KunYi/nRFMicro/3D Models/USP-6C.step

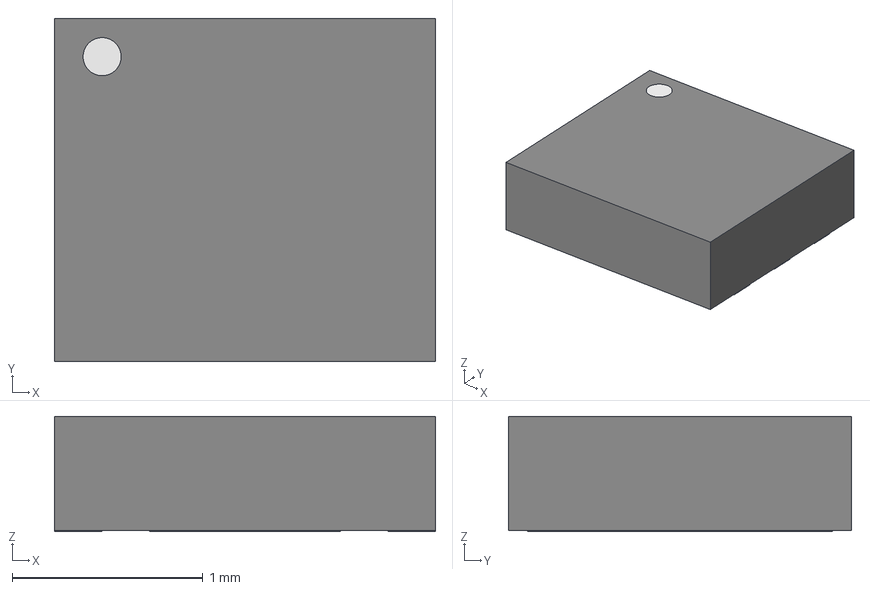
[picture p1: CAD file, 2025-09-13]
3D Models/USP-6C.step
2.00 x 1.80 x 0.605 mm
PIN_EP
PIN001
PIN006
PIN002 x 4
Indicator
