KunYi/nRFMicro/Documents/BoardOutline/BoardOutline-Shape2DView.dxf

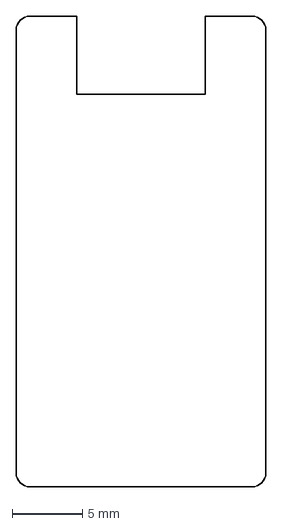
[picture p2: CAD file, 2025-09-13]
Documents/BoardOutline/BoardOutline-Shape2DView.dxf
17.8 x 33.5 mm
