KunYi/nRFMicro/3D Models/Nordic_AQFN-73-1EP_7x7mm_P0.5mm.step

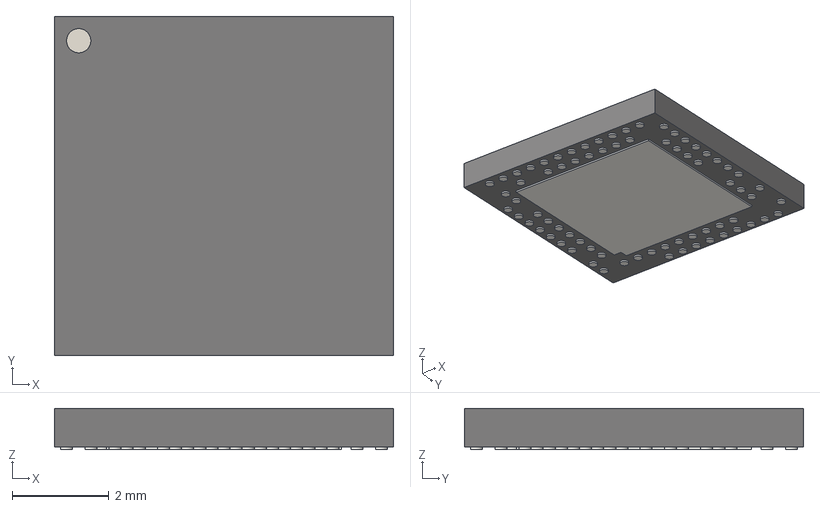
[picture p3: CAD file, 2025-09-13]
3D Models/Nordic_AQFN-73-1EP_7x7mm_P0.5mm.step
7.00 x 7.00 x 0.85 mm
