KunYi/nRFMicro/Documents/BoardOutline/BoardOutline.FCStd

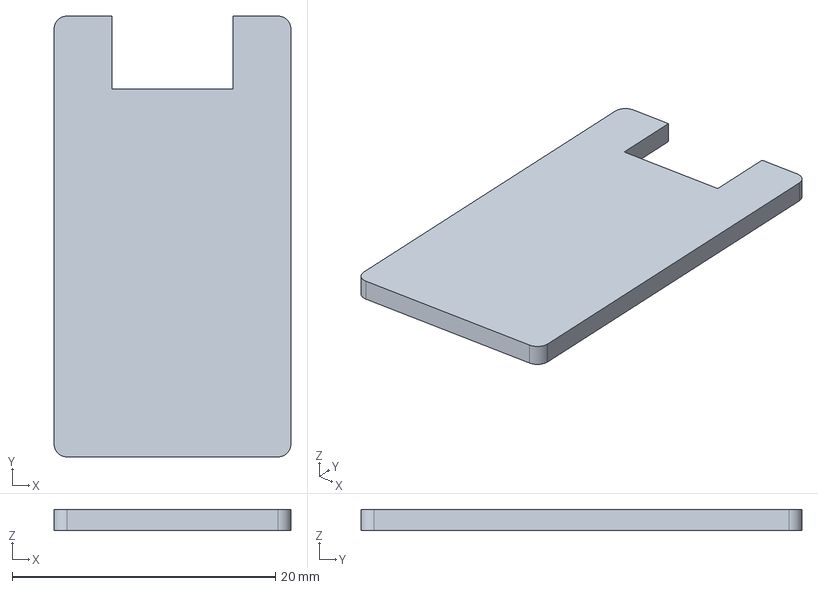
[picture p4: CAD file, 2025-09-13]
Documents/BoardOutline/BoardOutline.FCStd
18.0 x 33.5 x 1.60 mm
