KunYi/nRFMicro/3D Models/C_0402_1005Metric.step

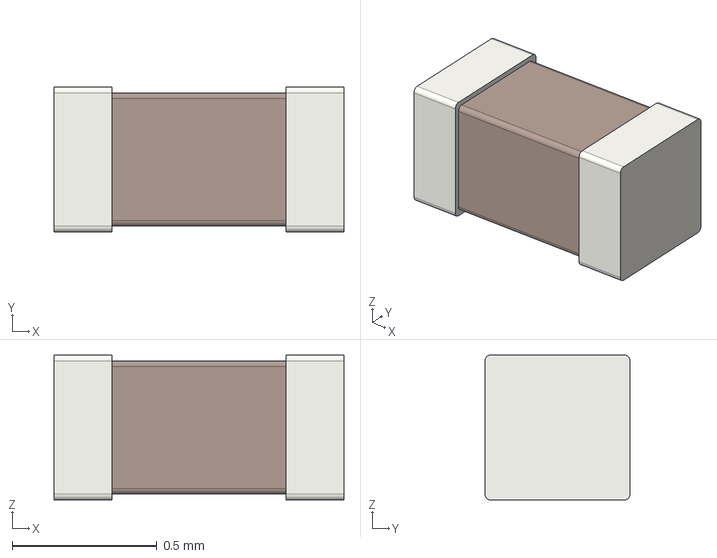
[picture p5: CAD file, 2025-09-13]
3D Models/C_0402_1005Metric.step
1.00 x 0.5 x 0.5 mm
