KunYi/nRFMicro/3D Models/USB-C-C168688.step

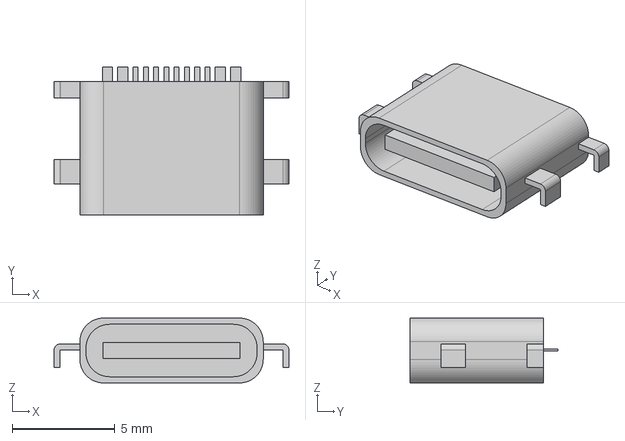
[picture p7: CAD file, 2025-09-13]
3D Models/USB-C-C168688.step
11.5 x 7.20 x 3.16 mm
