KunYi/nRFMicro/3D Models/USBLC6-2P6.step

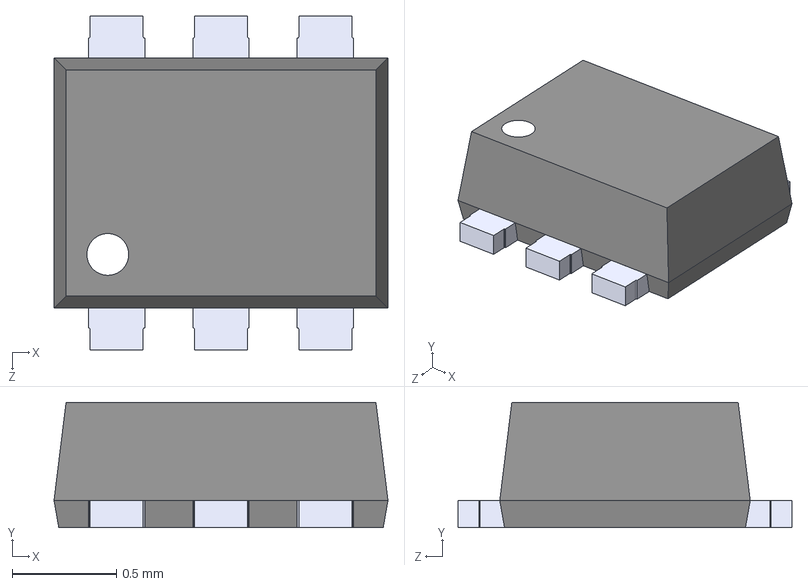
[picture p8: CAD file, 2025-09-13]
3D Models/USBLC6-2P6.step
1.60 x 0.6 x 1.60 mm
