KunYi/nRFMicro/3D Models/ABS06-127-32.768KHZ-T.step

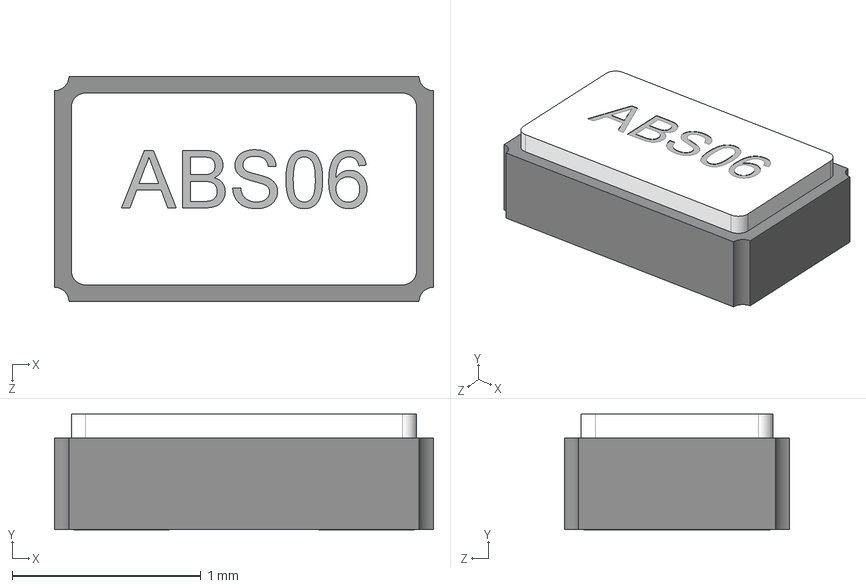
[picture p9: CAD file, 2025-09-13]
3D Models/ABS06-127-32.768KHZ-T.step
2.01 x 0.612 x 1.19 mm
