KunYi/nRFMicro/3D Models/C_0603_1608Metric.step

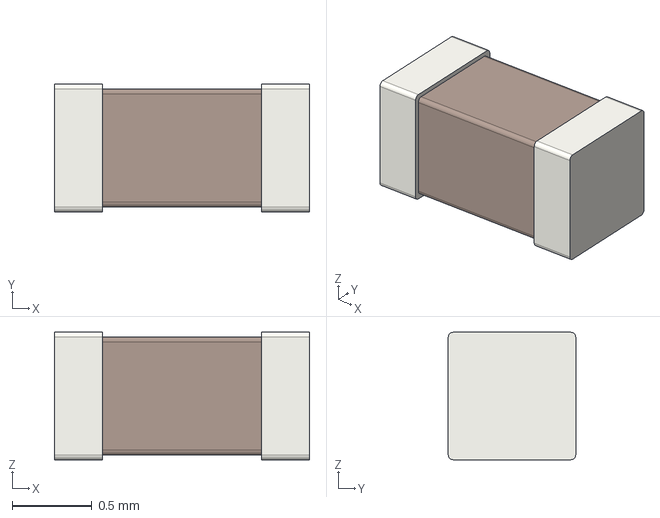
[picture p10: CAD file, 2025-09-13]
3D Models/C_0603_1608Metric.step
1.60 x 0.8 x 0.8 mm
