KunYi/nRFMicro/3D Models/Epson FA-128.step

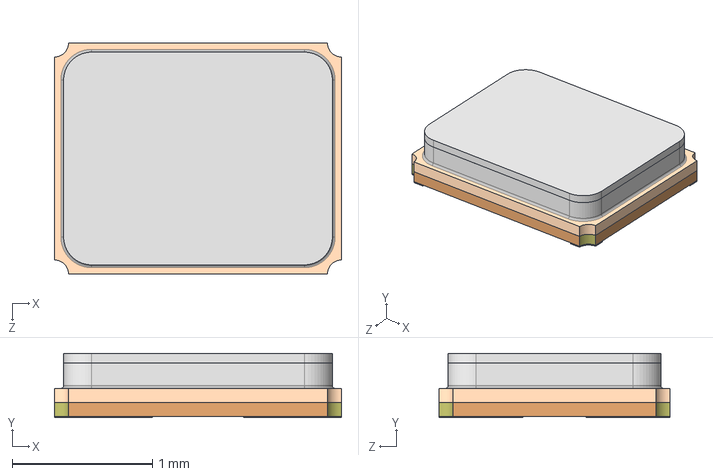
[picture p11: CAD file, 2025-09-13]
3D Models/Epson FA-128.step
2.05 x 0.46 x 1.65 mm
