KunYi/nRFMicro/3D Models/USB4520-03-0-A.STEP

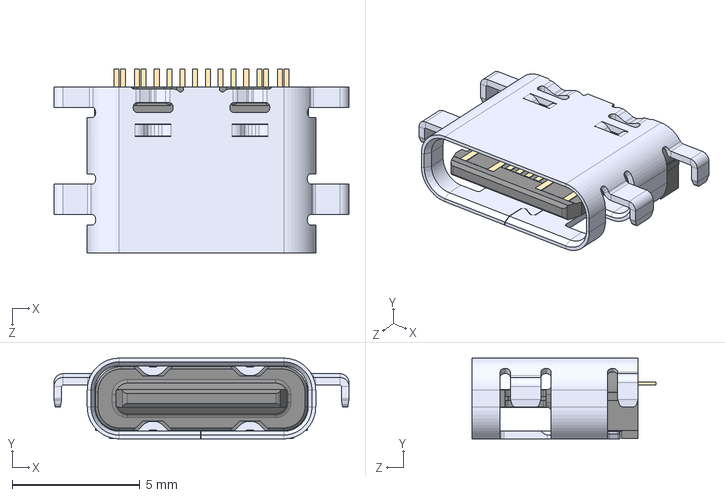
[picture p12: CAD file, 2025-09-13]
3D Models/USB4520-03-0-A.STEP
11.5 x 3.16 x 7.20 mm
