KunYi/nRFMicro/3D Models/BQ25185DLHR.step

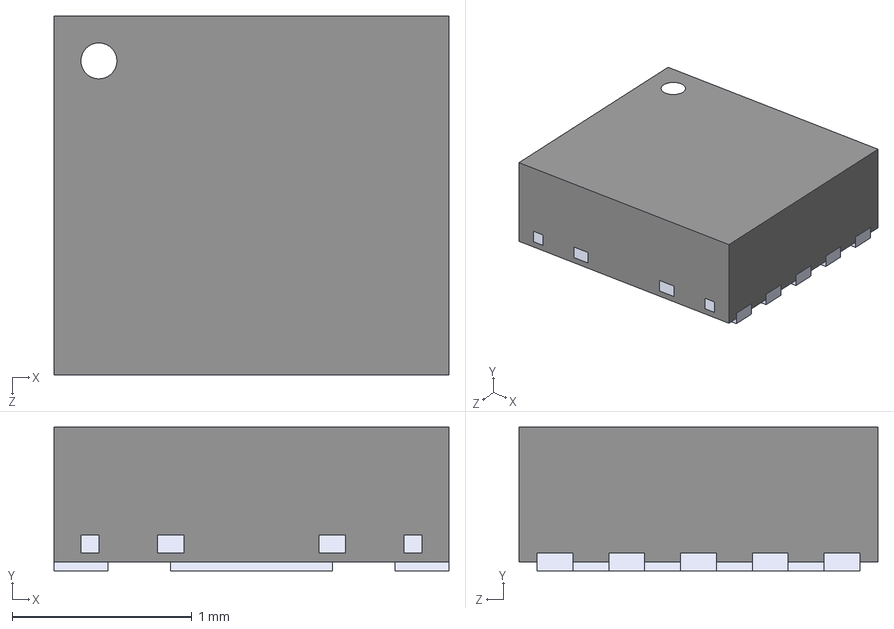
[picture p13: CAD file, 2025-09-13]
3D Models/BQ25185DLHR.step
2.20 x 0.8 x 2.00 mm
