KunYi/nRFMicro/(list of files, cad)

Other CAD files:
3D Models/USP-6C.FCStd
Documents/BoardOutline/BoardOutline.dxf
