KunYi/nRFMicro/nRFMicro.kicad_pcb

## KiCad design nRFMicro.kicad_pcb (2025-09-13)

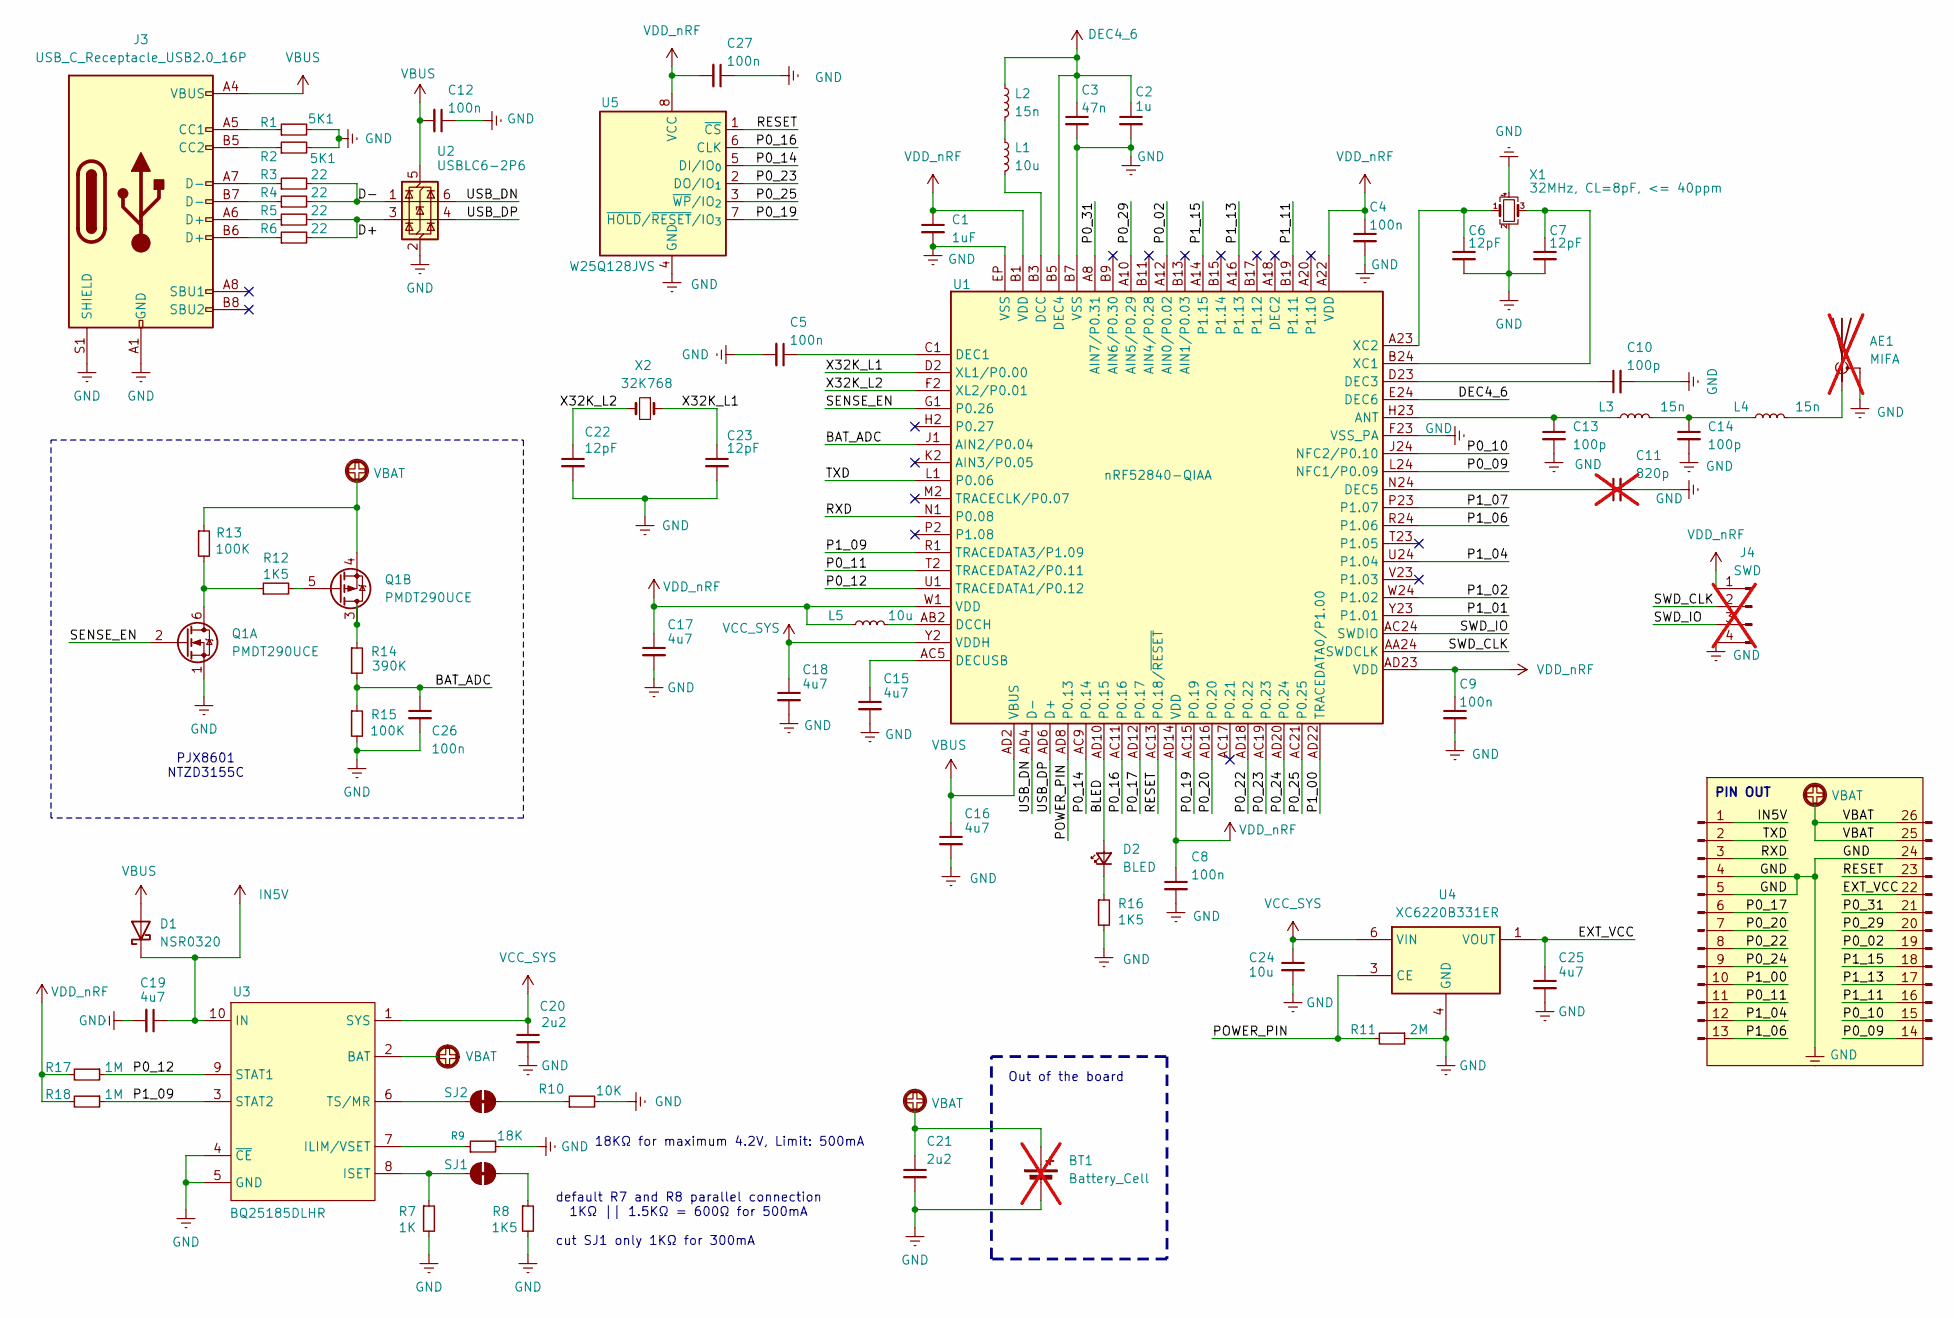
[picture p14: schematic nRFMicro.kicad_sch]

Parts:
AE1: MIFA; BLE_ANTENNA; not fitted
BP1: ProMicroPinHeader
BT1: Battery_Cell; not fitted
C1: 1uF; C_0402_1005Metric; Part No GRM155Z71A105KE1D; LCSC C528974
C2: 1u; C_0402_1005Metric; Part No GRM155Z71A105KE1D; LCSC C528974
C3: 47n; C_0402_1005Metric; Part No GRM155Z71A105KE1D; LCSC C528974
C4, C5, C8, C9, C12, C26, C27: 100n; C_0402_1005Metric; Part No GRM155Z71A105KE1D; LCSC C528974
C6, C7, C22, C23: 12pF; C_0402_1005Metric; Part No GRM155Z71A105KE1D; LCSC C528974
C10, C13, C14: 100p; C_0402_1005Metric; Part No GRM155Z71A105KE1D; LCSC C528974
C11: 820p; C_0402_1005Metric; Part No GRM155Z71A105KE1D; LCSC C528974; not fitted
C15, C16, C17, C18, C19, C25: 4u7; C_0402_1005Metric; Part No CL05A475MO5NUNC; LCSC C318563
C20, C21: 2u2; C_0402_1005Metric; Part No GRM155Z71A105KE1D; LCSC C528974
C24: 10u; C_0402_1005Metric; Part No CL05A475MO5NUNC; LCSC C318563
D1: NSR0320; D_SOD-323; Part No NSR0320MW2T1G; LCSC C48192
D2: BLED; LED_0402_1005Metric
J3: USB_C_Receptacle_USB2.0_16P; USB-C_C168688; Part No 918-418K2024S40000; LCSC C168688
J4: SWD; SWD_CONNECTOR; not fitted
L1, L5: 10u; L_0603_1608Metric; Part No MLZ1608E100MT; LCSC C340673
L2, L3, L4: 15n; L_0402_1005Metric; Part No MLZ1608E100MT; LCSC C340673
Q1: PMDT290UCE; SOT-666
R1, R2: 5K1; R_0402_1005Metric
R3, R4, R5, R6: 22; R_0402_1005Metric
R7: 1K; R_0402_1005Metric
R8, R12, R16: 1K5; R_0402_1005Metric
R9: 18K; R_0402_1005Metric
R10: 10K; R_0402_1005Metric
R11: 2M; R_0402_1005Metric
R13, R15: 100K; R_0402_1005Metric
R14: 390K; R_0402_1005Metric
R17, R18: 1M; R_0402_1005Metric
SJ1, SJ2: StrappingJump
U1: nRF52840-QIAA; Nordic_AQFN-73-1EP_7x7mm_P0.5mm
U2: USBLC6-2P6; LCSC C2827693
U3: BQ25185DLHR; Part No BQ25185DLHR; LCSC C19725033
U4: XC6220B331ER; USP6-C
U5: W25Q128JVS; SOIC-8_5.3x5.3mm_P1.27mm
X1: 32MHz, CL=8pF, <= 40ppm; Crystal_SMD_SeikoEpson_FA128-4Pin_2.0x1.6mm
X2: 32K768; SMD2016-2P; Part No SC20S-12.5PF20PPM; LCSC C97607

Connections:
/BAT_ADC: C26.1, R14.2, R15.1, U1.J1 (AIN2/P0.04)
/BLED: D2.2 (A), U1.AD10 (P0.15)
/D+: R5.2, R6.2, U2.3 (I/O2)
/D-: R3.2, R4.2, U2.1 (I/O1)
/P0_02: BP1.19, U1.A12 (AIN0/P0.02)
/P0_09: BP1.14, U1.L24 (NFC1/P0.09)
/P0_10: BP1.15, U1.J24 (NFC2/P0.10)
/P0_11: BP1.11, U1.T2 (TRACEDATA2/P0.11)
/P0_12: R17.1, U1.U1 (TRACEDATA1/P0.12), U3.9 (STAT1)
/P0_14: U1.AC9 (P0.14), U5.5 (DI/IO_{0})
/P0_16: U1.AC11 (P0.16), U5.6 (CLK)
/P0_17: BP1.6, U1.AD12 (P0.17)
/P0_19: U1.AC15 (P0.19), U5.7 (~HOLD/~RESET/IO_{3})
/P0_20: BP1.7, U1.AD16 (P0.20)
/P0_22: BP1.8, U1.AD18 (P0.22)
/P0_23: U1.AC19 (P0.23), U5.2 (DO/IO_{1})
/P0_24: BP1.9, U1.AD20 (P0.24)
/P0_25: U1.AC21 (P0.25), U5.3 (~WP/IO_{2})
/P0_29: BP1.20, U1.A10 (AIN5/P0.29)
/P0_31: BP1.21, U1.A8 (AIN7/P0.31)
/P1_00: BP1.10, U1.AD22 (TRACEDATA0/P1.00)
/P1_01: U1.Y23 (P1.01)
/P1_02: U1.W24 (P1.02)
/P1_04: BP1.12, U1.U24 (P1.04)
/P1_06: BP1.13, U1.R24 (P1.06)
/P1_07: U1.P23 (P1.07)
/P1_09: R18.1, U1.R1 (TRACEDATA3/P1.09), U3.3 (STAT2)
/P1_11: BP1.16, U1.B19 (P1.11)
/P1_13: BP1.17, U1.A16 (P1.13)
/P1_15: BP1.18, U1.A14 (P1.15)
/POWER_PIN: R11.2, U1.AD8 (P0.13), U4.3 (CE)
/RESET: BP1.23, U1.AC13 (P0.18/~RESET), U5.1 (~CS)
/RXD: BP1.3, U1.N1 (P0.08)
/SENSE_EN: Q1.2 (GN), U1.G1 (P0.26)
/SWD_CLK: J4.2, U1.AA24 (SWDCLK)
/SWD_IO: J4.3, U1.AC24 (SWDIO)
/TXD: BP1.2, U1.L1 (P0.06)
/USB_DN: U1.AD4 (D-), U2.6 (I/O1)
/USB_DP: U1.AD6 (D+), U2.4 (I/O2)
/X32K_L1: C23.1, U1.D2 (XL1/P0.00), X2.1
/X32K_L2: C22.1, U1.F2 (XL2/P0.01), X2.2
DEC4_6: C2.1, C3.1, L2.1, U1.B5 (DEC4), U1.E24 (DEC6)
GND: AE1.2 (Shield), BP1.4, BP1.5, BP1.24, BT1.2 (-), C1.2, C2.2, C3.2, C4.2, C5.2, C6.2, C7.2, C8.2, C9.2, C10.2, C11.2, C12.1, C13.2, C14.2, C15.2, C16.2, C17.2, C18.2, C19.2, C20.2, C21.2, C22.2, C23.2, C24.2, C25.2, C26.2, C27.1, J3.A1 (GND), J3.A12 (GND), J3.B1 (GND), J3.B12 (GND), J3.S1 (SHIELD), J3.S2 (SHIELD), J3.S3 (SHIELD), J3.S4 (SHIELD), J4.4, Q1.1 (SN), R1.2, R2.2, R7.2, R8.2, R9.2, R10.2, R11.1, R15.2, R16.2, U1.B7 (VSS), U1.EP (VSS), U1.F23 (VSS_PA), U2.2 (GND), U3.4 (~CE), U3.5 (GND), U3.11 (EP), U4.4 (GND), U4.EP, U5.4 (GND), X1.2, X1.4
IN5V: BP1.1, C19.1, D1.1 (K), U3.10 (IN)
unnamed: AE1.1 (A), L4.2
unnamed: C14.1, L3.2, L4.1
unnamed: D2.1 (K), R16.1
unnamed: J3.A5 (CC1), R1.1
unnamed: J3.B5 (CC2), R2.1
unnamed: J3.A6 (D+), R5.1
unnamed: J3.B6 (D+), R6.1
unnamed: J3.A7 (D-), R3.1
unnamed: J3.B7 (D-), R4.1
unnamed: L1.1, L2.2
unnamed: Q1.6 (DN), R12.1, R13.2
unnamed: Q1.3 (DP), R14.1
unnamed: Q1.5 (GP), R12.2
unnamed: R8.1, SJ1.2
unnamed: R10.1, SJ2.2
unnamed: C13.1, L3.1, U1.H23 (ANT)
unnamed: L1.2, U1.B3 (DCC)
unnamed: L5.2, U1.AB2 (DCCH)
unnamed: C5.1, U1.C1 (DEC1)
unnamed: C10.1, U1.D23 (DEC3)
unnamed: C11.1, U1.N24 (DEC5)
unnamed: C15.1, U1.AC5 (DECUSB)
unnamed: C7.1, U1.B24 (XC1), X1.3
unnamed: C6.1, U1.A23 (XC2), X1.1
unnamed: R9.1, U3.7 (ILIM/VSET)
unnamed: R7.1, SJ1.1, U3.8 (ISET)
unnamed: SJ2.1, U3.6 (TS/MR)
VBAT: BP1.25, BP1.26, BT1.1 (+), C21.1, Q1.4 (SP), R13.1, U3.2 (BAT)
VBUS: C12.2, C16.1, D1.2 (A), J3.A4 (VBUS), J3.A9 (VBUS), J3.B4 (VBUS), J3.B9 (VBUS), U1.AD2 (VBUS), U2.5 (VBUS)
VCC_SYS: C18.1, C20.1, C24.1, U1.Y2 (VDDH), U3.1 (SYS), U4.5 (VIN), U4.6 (VIN)
VDD_nRF: C1.1, C4.1, C8.1, C9.1, C17.1, C27.2, J4.1, L5.1, R17.2, R18.2, U1.A22 (VDD), U1.AD14 (VDD), U1.AD23 (VDD), U1.B1 (VDD), U1.W1 (VDD), U5.8 (VCC)
VOUT: BP1.22, C25.1, U4.1 (VOUT), U4.2 (VOUT)

Notes on the sheet:
default R7 and R8 parallel connection 1KΩ || 1.5KΩ = 600Ω for 500mA cut SJ1 only 1KΩ for 300mA
PIN OUT
PJX8601 NTZD3155C
Out of the board
18KΩ for maximum 4.2V, Limit: 500mA

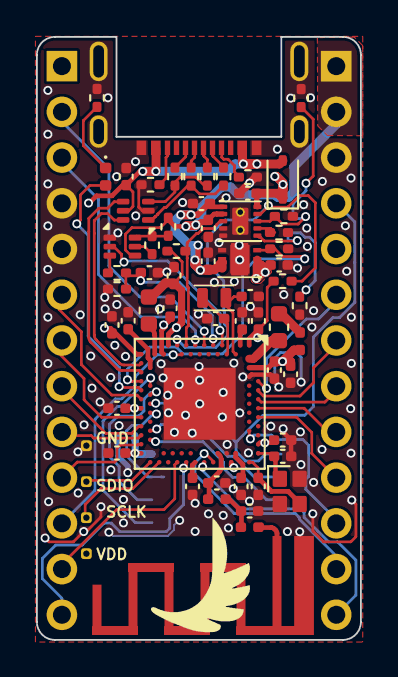
[picture p15: board nRFMicro.kicad_pcb from above]

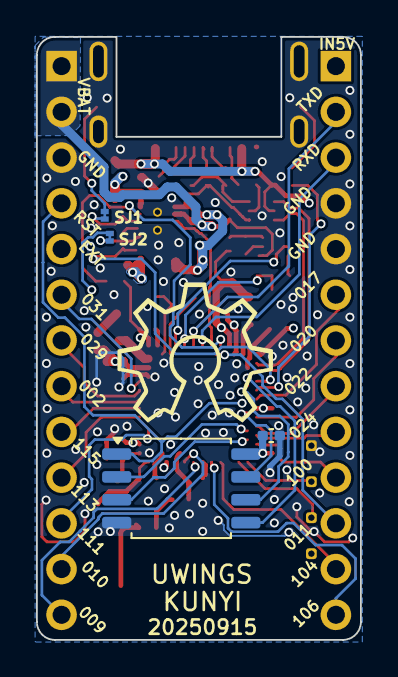
[picture p16: board nRFMicro.kicad_pcb from below]

Board: 4 copper layers, 18.0 x 33.5 mm, 66 parts (5 on the bottom side), 73 nets.
